FelTell/Keyboard-FT/Firmware/Roadmap.md

- Add bluetooth 
- Save connected devices in NVS
- Implement sleep
- Add LampArray operation to control LEDs from OS
