FelTell/Keyboard-FT/Hardware/Keyboard.kicad_pcb

## KiCad design Hardware/Keyboard.kicad_pcb (2024-02-05)

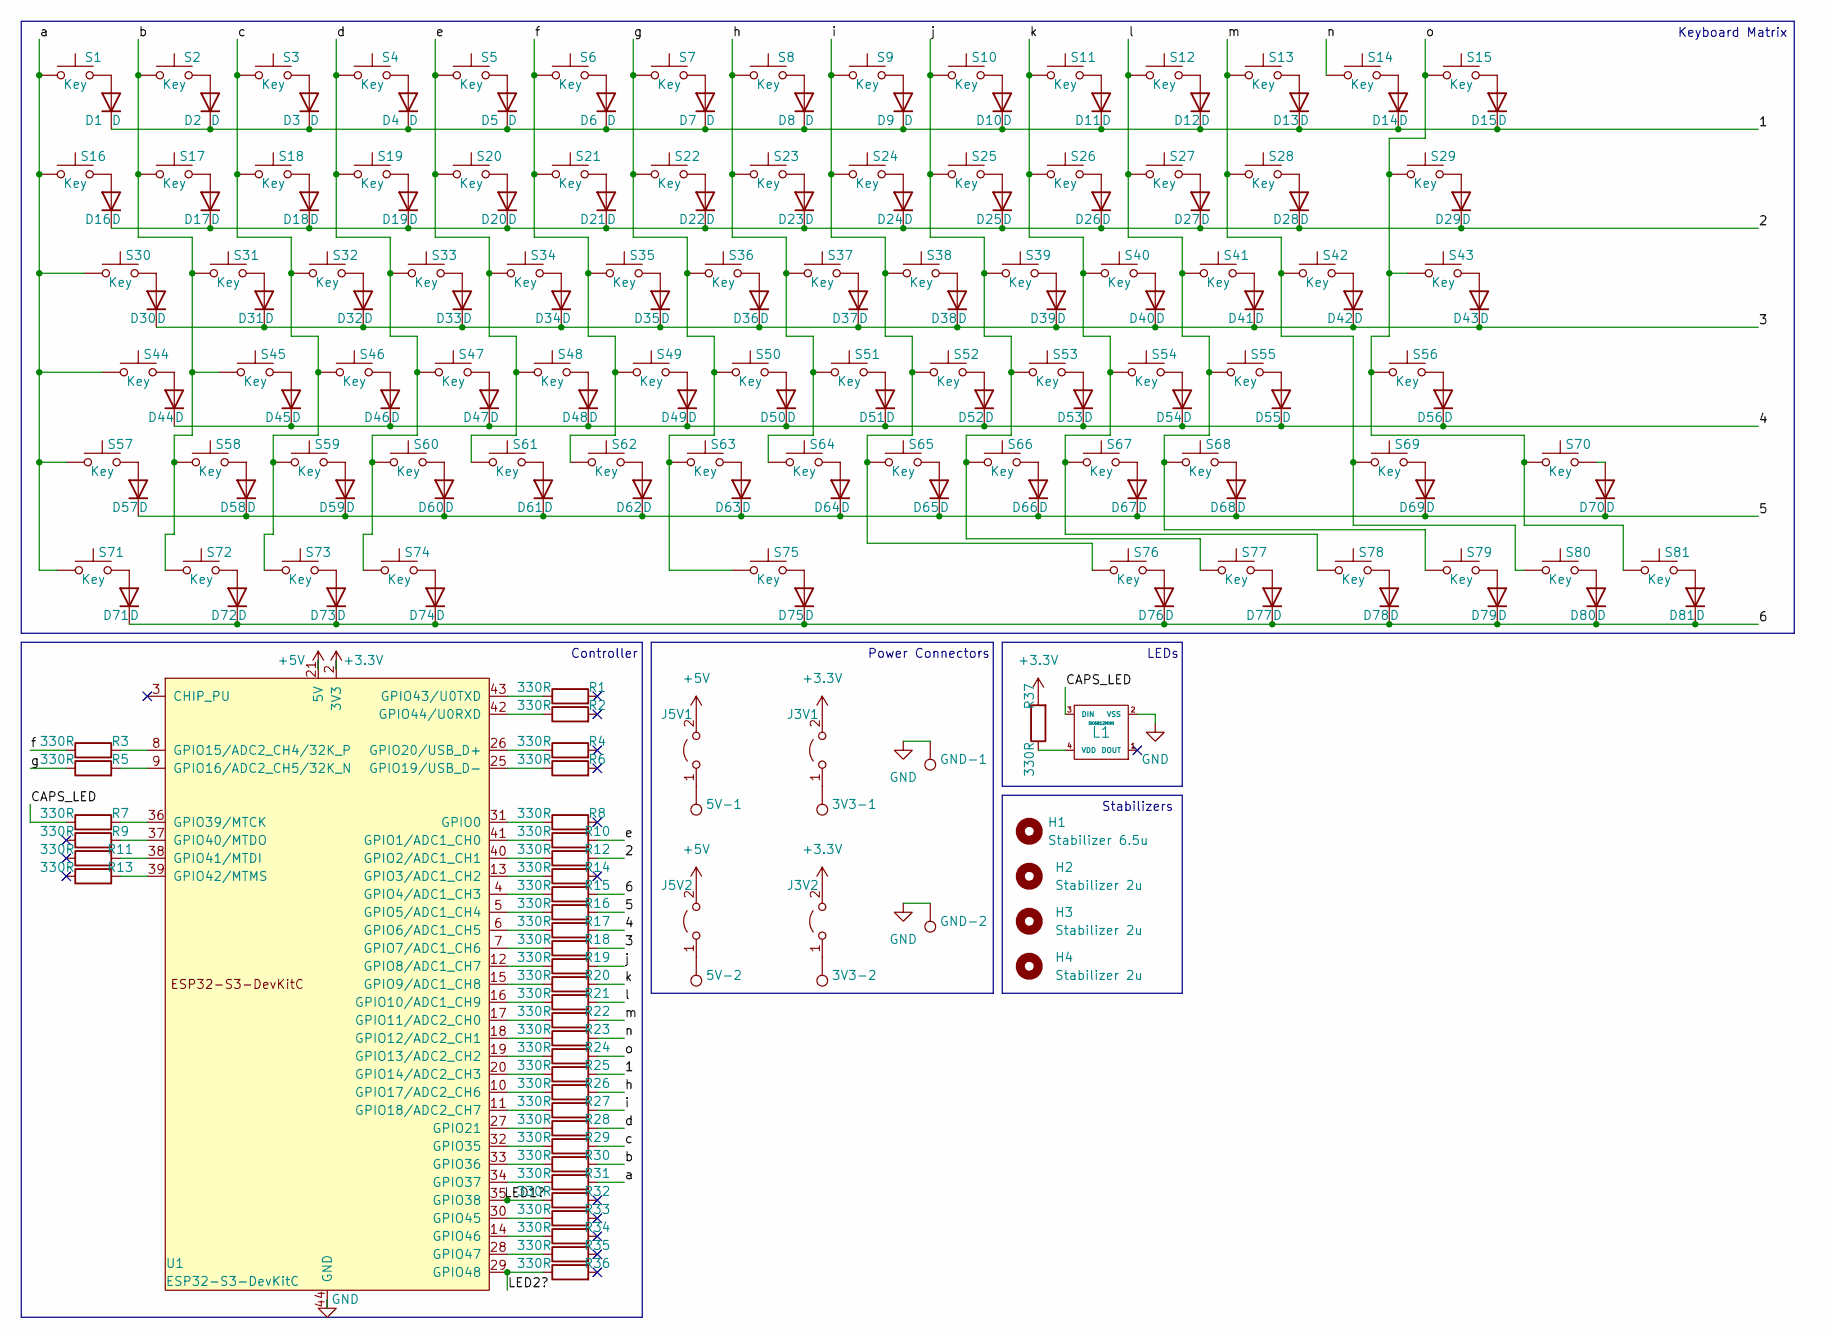
[picture p1: schematic PCB.kicad_sch, Keyboard-FT]

Parts:
3V3-1, 3V3-2, 5V-1, 5V-2: TestPoint; PinHeader_1x01_P1.00mm_Vertical
D1, D2, D3, D4, D5, D6, D7, D8, D9, D10, D11, D12, D13, D14, D15, D16, D17, D18, D19, D20, D21, D22, D23, D24, D25, D26, D27, D28, D29, D30, D31, D32, D33, D34, D35, D36, D37, D38, D39, D40, D41, D42, D43, D44, D45, D46, D47, D48, D49, D50, D51, D52, D53, D54, D55, D56, D57, D58, D59, D60, D61, D62, D63, D64, D65, D66, D67, D68, D69, D70, D71, D72, D73, D74, D75, D76, D77, D78, D79, D80, D81: D; D3_TH_SMD_v2
GND-1, GND-2: TestPoint; PinHeader_1x01_P1.00mm_Vertical
H1: Stabilizer 6.5u; Stabilizer_Cherry_MX_6.25u
H2, H3, H4: Stabilizer 2u; Stabilizer_Cherry_MX_2.00u
J3V1, J3V2, J5V1, J5V2: Jumper_2_Open; SolderJumper-2_P1.3mm_Open_TrianglePad1.0x1.5mm
L1: SK6812MINI; SK6812MINI_rev
R1, R2, R3, R4, R5, R6, R7, R8, R9, R10, R11, R12, R13, R14, R15, R16, R17, R18, R19, R20, R21, R22, R23, R24, R25, R26, R27, R28, R29, R30, R31, R32, R33, R34, R35, R36, R37: 330R; R_0603_1608Metric_Pad0.98x0.95mm_HandSolder
S1, S2, S3, S4, S5, S6, S7, S8, S9, S10, S11, S12, S13, S14, S15, S16, S17, S18, S19, S20, S21, S22, S23, S24, S25, S26, S27, S28, S31, S32, S33, S34, S35, S36, S37, S38, S39, S40, S41, S42, S45, S46, S47, S48, S49, S50, S51, S52, S53, S54, S55, S58, S59, S60, S61, S62, S63, S64, S65, S66, S67, S68, S70, S72, S73, S74, S77, S79, S80, S81: Key; SW_Cherry_MX_PCB_1.00u
S29: Key; SW_Cherry_MX_PCB_2.00u
S30, S43: Key; SW_Cherry_MX_PCB_1.50u
S44: Key; SW_Cherry_MX_PCB_1.75u
S56: Key; SW_Cherry_MX_PCB_2.25u
S57, S71, S76, S78: Key; SW_Cherry_MX_PCB_1.25u
S69: Key; SW_Cherry_MX_PCB_2.75u
S75: Key; SW_Cherry_MX_PCB_6.25u
U1: ESP32-S3-DevKitC

Connections:
+3.3V: J3V1.2 (B), J3V2.2 (B), R37.2, U1.1 (3V3), U1.2 (3V3)
+5V: J5V1.2 (B), J5V2.2 (B), U1.21 (5V)
/1: D1.1 (K), D2.1 (K), D3.1 (K), D4.1 (K), D5.1 (K), D6.1 (K), D7.1 (K), D8.1 (K), D9.1 (K), D10.1 (K), D11.1 (K), D12.1 (K), D13.1 (K), D14.1 (K), D15.1 (K), R25.2
/2: D16.1 (K), D17.1 (K), D18.1 (K), D19.1 (K), D20.1 (K), D21.1 (K), D22.1 (K), D23.1 (K), D24.1 (K), D25.1 (K), D26.1 (K), D27.1 (K), D28.1 (K), D29.1 (K), R12.2
/3: D30.1 (K), D31.1 (K), D32.1 (K), D33.1 (K), D34.1 (K), D35.1 (K), D36.1 (K), D37.1 (K), D38.1 (K), D39.1 (K), D40.1 (K), D41.1 (K), D42.1 (K), D43.1 (K), R18.2
/4: D44.1 (K), D45.1 (K), D46.1 (K), D47.1 (K), D48.1 (K), D49.1 (K), D50.1 (K), D51.1 (K), D52.1 (K), D53.1 (K), D54.1 (K), D55.1 (K), D56.1 (K), R17.2
/5: D57.1 (K), D58.1 (K), D59.1 (K), D60.1 (K), D61.1 (K), D62.1 (K), D63.1 (K), D64.1 (K), D65.1 (K), D66.1 (K), D67.1 (K), D68.1 (K), D69.1 (K), D70.1 (K), R16.2
/6: D71.1 (K), D72.1 (K), D73.1 (K), D74.1 (K), D75.1 (K), D76.1 (K), D77.1 (K), D78.1 (K), D79.1 (K), D80.1 (K), D81.1 (K), R15.2
/CAPS_LED: L1.3 (DIN), R7.1
/LED1?: R32.1, U1.35 (GPIO38)
/LED2?: R36.1, U1.29 (GPIO48)
/a: R31.2, S1.1, S16.1, S30.1, S44.1, S57.1, S71.1
/b: R30.2, S2.1, S17.1, S31.1, S45.1, S58.1, S72.1
/c: R29.2, S3.1, S18.1, S32.1, S46.1, S59.1, S73.1
/d: R28.2, S4.1, S19.1, S33.1, S47.1, S60.1, S74.1
/e: R10.2, S5.1, S20.1, S34.1, S48.1, S61.1
/f: R3.1, S6.1, S21.1, S35.1, S49.1, S62.1
/g: R5.1, S7.1, S22.1, S36.1, S50.1, S63.1, S75.1
/h: R26.2, S8.1, S23.1, S37.1, S51.1, S64.1
/i: R27.2, S9.1, S24.1, S38.1, S52.1, S65.1, S76.1
/j: R19.2, S10.1, S25.1, S39.1, S53.1, S66.1, S77.1
/k: R20.2, S11.1, S26.1, S40.1, S54.1, S67.1, S78.1
/l: R21.2, S12.1, S27.1, S41.1, S55.1, S68.1, S79.1
/m: R22.2, S13.1, S28.1, S42.1, S69.1, S80.1
/n: R23.2, S14.1
/o: R24.2, S15.1, S29.1, S43.1, S56.1, S70.1, S81.1
GND: GND-1.1, GND-2.1, L1.2 (VSS), U1.22 (GND), U1.23 (GND), U1.24 (GND), U1.44 (GND); also elsewhere on the board
unnamed: D1.2 (A), S1.2
unnamed: D2.2 (A), S2.2
unnamed: D3.2 (A), S3.2
unnamed: D4.2 (A), S4.2
unnamed: D5.2 (A), S5.2
unnamed: D6.2 (A), S6.2
unnamed: D7.2 (A), S7.2
unnamed: D8.2 (A), S8.2
unnamed: D9.2 (A), S9.2
unnamed: D10.2 (A), S10.2
unnamed: D11.2 (A), S11.2
unnamed: D12.2 (A), S12.2
unnamed: D13.2 (A), S13.2
unnamed: D14.2 (A), S14.2
unnamed: D15.2 (A), S15.2
unnamed: D16.2 (A), S16.2
unnamed: D17.2 (A), S17.2
unnamed: D18.2 (A), S18.2
unnamed: D19.2 (A), S19.2
unnamed: D20.2 (A), S20.2
unnamed: D21.2 (A), S21.2
unnamed: D22.2 (A), S22.2
unnamed: D23.2 (A), S23.2
unnamed: D24.2 (A), S24.2
unnamed: D25.2 (A), S25.2
unnamed: D26.2 (A), S26.2
unnamed: D27.2 (A), S27.2
unnamed: D28.2 (A), S28.2
unnamed: D29.2 (A), S29.2
unnamed: D30.2 (A), S30.2
unnamed: D31.2 (A), S31.2
unnamed: D32.2 (A), S32.2
unnamed: D33.2 (A), S33.2
unnamed: D34.2 (A), S34.2
unnamed: D35.2 (A), S35.2
unnamed: D36.2 (A), S36.2
unnamed: D37.2 (A), S37.2
unnamed: D38.2 (A), S38.2
unnamed: D39.2 (A), S39.2
unnamed: D40.2 (A), S40.2
unnamed: D41.2 (A), S41.2
unnamed: D42.2 (A), S42.2
unnamed: D43.2 (A), S43.2
unnamed: D44.2 (A), S44.2
unnamed: D45.2 (A), S45.2
unnamed: D46.2 (A), S46.2
unnamed: D47.2 (A), S47.2
unnamed: D48.2 (A), S48.2
unnamed: D49.2 (A), S49.2
unnamed: D50.2 (A), S50.2
unnamed: D51.2 (A), S51.2
unnamed: D52.2 (A), S52.2
unnamed: D53.2 (A), S53.2
unnamed: D54.2 (A), S54.2
unnamed: D55.2 (A), S55.2
unnamed: D56.2 (A), S56.2
unnamed: D57.2 (A), S57.2
unnamed: D58.2 (A), S58.2
unnamed: D59.2 (A), S59.2
unnamed: D60.2 (A), S60.2
unnamed: D61.2 (A), S61.2
unnamed: D62.2 (A), S62.2
unnamed: D63.2 (A), S63.2
unnamed: D64.2 (A), S64.2
unnamed: D65.2 (A), S65.2
unnamed: D66.2 (A), S66.2
unnamed: D67.2 (A), S67.2
unnamed: D68.2 (A), S68.2
unnamed: D69.2 (A), S69.2
unnamed: D70.2 (A), S70.2
unnamed: D71.2 (A), S71.2
unnamed: D72.2 (A), S72.2
unnamed: D73.2 (A), S73.2
unnamed: D74.2 (A), S74.2
unnamed: D75.2 (A), S75.2
unnamed: D76.2 (A), S76.2
unnamed: D77.2 (A), S77.2
unnamed: D78.2 (A), S78.2
unnamed: D79.2 (A), S79.2
unnamed: D80.2 (A), S80.2
unnamed: D81.2 (A), S81.2
unnamed 108: 3V3-1.1, J3V1.1 (A); also elsewhere on the board
unnamed: 3V3-2.1, J3V2.1 (A)
unnamed 110: 5V-1.1, J5V1.1 (A); also elsewhere on the board
unnamed: 5V-2.1, J5V2.1 (A)
unnamed: L1.4 (VDD), R37.1
unnamed: R8.1, U1.31 (GPIO0)
unnamed: R10.1, U1.41 (GPIO1/ADC1_CH0)
unnamed: R12.1, U1.40 (GPIO2/ADC1_CH1)
unnamed: R14.1, U1.13 (GPIO3/ADC1_CH2)
unnamed: R15.1, U1.4 (GPIO4/ADC1_CH3)
unnamed: R16.1, U1.5 (GPIO5/ADC1_CH4)
unnamed: R17.1, U1.6 (GPIO6/ADC1_CH5)
unnamed: R18.1, U1.7 (GPIO7/ADC1_CH6)
unnamed: R19.1, U1.12 (GPIO8/ADC1_CH7)
unnamed: R20.1, U1.15 (GPIO9/ADC1_CH8)
unnamed: R21.1, U1.16 (GPIO10/ADC1_CH9)
unnamed: R22.1, U1.17 (GPIO11/ADC2_CH0)
unnamed: R23.1, U1.18 (GPIO12/ADC2_CH1)
unnamed: R24.1, U1.19 (GPIO13/ADC2_CH2)
unnamed: R25.1, U1.20 (GPIO14/ADC2_CH3)
unnamed: R3.2, U1.8 (GPIO15/ADC2_CH4/32K_P)
unnamed: R5.2, U1.9 (GPIO16/ADC2_CH5/32K_N)
unnamed: R26.1, U1.10 (GPIO17/ADC2_CH6)
unnamed: R27.1, U1.11 (GPIO18/ADC2_CH7)
unnamed: R6.1, U1.25 (GPIO19/USB_D-)
unnamed: R4.1, U1.26 (GPIO20/USB_D+)
unnamed: R28.1, U1.27 (GPIO21)
unnamed: R29.1, U1.32 (GPIO35)
unnamed: R30.1, U1.33 (GPIO36)
unnamed: R31.1, U1.34 (GPIO37)
unnamed: R7.2, U1.36 (GPIO39/MTCK)
unnamed: R9.2, U1.37 (GPIO40/MTDO)
unnamed: R11.2, U1.38 (GPIO41/MTDI)
unnamed: R13.2, U1.39 (GPIO42/MTMS)
unnamed: R1.1, U1.43 (GPIO43/U0TXD)
unnamed: R2.1, U1.42 (GPIO44/U0RXD)
unnamed: R33.1, U1.30 (GPIO45)
unnamed: R34.1, U1.14 (GPIO46)
unnamed: R35.1, U1.28 (GPIO47)

Notes on the sheet:
Keyboard Matrix
Controller
Power Connectors
LEDs
Stabilizers

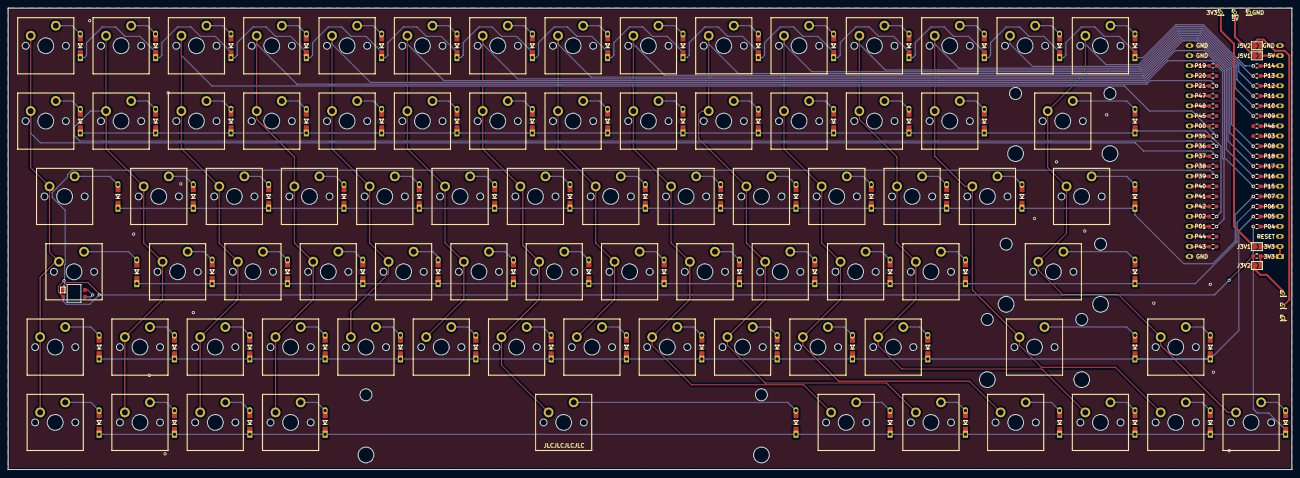
[picture p2: board Keyboard.kicad_pcb from above]

Board: 2 copper layers, 324.6 x 116.7 mm, 215 parts (1 on the bottom side), 147 nets.

Other parts of the board:
3V3, 5V: TestPoint; PinHeader_1x01_P1.00mm_Vertical
GND: TestPoint; PinHeader_1x01_P1.00mm_Vertical

Their connections:
GND: GND.1; also elsewhere on the board
unnamed 108: 3V3.1; also elsewhere on the board
unnamed 110: 5V.1; also elsewhere on the board
