FelTell/Keyboard-FT/Firmware/main/Src/UsbHid.cpp

#include "UsbHid.hpp"

#include <algorithm>
#include <cstdlib>

#include <class/hid/hid_device.h>
#include <esp_log.h>
#include <tinyusb.h>
#include <tinyusb_default_config.h>

#include "RtosUtils.hpp"

#include "Leds.hpp"

namespace usb_hid {

static constexpr uint8_t REPORT_MAX_KEYS = 6;
static constexpr uint8_t REPORT_SIZE     = 2 + REPORT_MAX_KEYS;

static bool Init();
static void Handler();

static void PollConnection();
static void PrintReport(std::array<uint8_t, REPORT_SIZE>& report);

static rtos::Task task("UsbHidTask", 4096, 23, Init, Handler, 0);
static rtos::Timer pollConnectionTimer("PollConnectionTimer",
                                       100,
                                       true,
                                       PollConnection);
static rtos::Queue<KbHidReport> kbReportsQueue(10);
// TODO (Felipe): This should be a semaphore
static rtos::Event hidReady;

static bool isReady;

// TinyUSB descriptors

static constexpr uint8_t KEYBOARD_REPORT_ID = 1;
static constexpr uint8_t CONSUMER_REPORT_ID = 3;

static constexpr uint32_t TUSB_DESC_TOTAL_LEN =
    TUD_CONFIG_DESC_LEN + CFG_TUD_HID * TUD_HID_DESC_LEN;

static const uint8_t reportDescriptor[] = {
    TUD_HID_REPORT_DESC_KEYBOARD(HID_REPORT_ID(KEYBOARD_REPORT_ID)),
    TUD_HID_REPORT_DESC_CONSUMER(HID_REPORT_ID(CONSUMER_REPORT_ID))};

static const char* stringDescriptor[5] = {
    (char[]){0x09, 0x04}, // 0: is supported language is English (0x0409)
    "FelTell",            // 1: Manufacturer
    "Keyboard-FT",        // 2: Product
    "0000001",            // 3: Serial,
    "Keyboard-FT V1.0",   // 4: HID
};

static const uint8_t configurationDescriptor[] = {
    TUD_CONFIG_DESCRIPTOR(1,
                          1,
                          0,
                          TUSB_DESC_TOTAL_LEN,
                          TUSB_DESC_CONFIG_ATT_REMOTE_WAKEUP,
                          100),

    TUD_HID_DESCRIPTOR(0, 4, false, sizeof(reportDescriptor), 0x81, 16, 10),
};

bool SendReport(KbHidReport kbHidReport) {
    return kbReportsQueue.Send(kbHidReport);
}

static bool Init() {
    tinyusb_config_t tinyUsbConfig             = TINYUSB_DEFAULT_CONFIG();
    tinyUsbConfig.task.priority                = 24;
    tinyUsbConfig.task.xCoreID                 = 0;
    tinyUsbConfig.descriptor.device            = NULL;
    tinyUsbConfig.descriptor.full_speed_config = configurationDescriptor;
    tinyUsbConfig.descriptor.string            = stringDescriptor;
    tinyUsbConfig.descriptor.string_count =
        sizeof(stringDescriptor) / sizeof(stringDescriptor[0]);

    ESP_ERROR_CHECK(tinyusb_driver_install(&tinyUsbConfig));

    pollConnectionTimer.Start();

    return true;
}

static void Handler() {
    static uint16_t lastConsumerCode;
    static std::array<uint8_t, REPORT_SIZE> keyCodes = {};

    hidReady.Wait(1);
    KbHidReport report;
    kbReportsQueue.Wait(report);

    if (lastConsumerCode != report.consumerCode) {
        lastConsumerCode = report.consumerCode;
        tud_hid_report(CONSUMER_REPORT_ID, &lastConsumerCode, 2);
        ESP_LOGI("ConsumerReport: ", "%d", report.consumerCode);
        return;
    }

    keyCodes[0] = report.modifiers;
    memcpy(&keyCodes[2], report.keys.data(), REPORT_MAX_KEYS);

    hidReady.Clear(1);
    tud_hid_report(KEYBOARD_REPORT_ID, keyCodes.data(), REPORT_SIZE);

    PrintReport(keyCodes);

    leds::ResetTimeout();
}

static void PollConnection() {
    const bool tinyUsbReady = tud_ready();
    if (isReady != tinyUsbReady) {
        isReady = tinyUsbReady;
        if (!isReady) {
            isReady = false;
            leds::SendCommand(leds::Commands::NotConnected);
        } else if (leds::GetMode() == leds::Commands::NotConnected) {
            leds::SendCommand(leds::Commands::Usb);
        }
    }
}

static void PrintReport(std::array<uint8_t, REPORT_SIZE>& report) {
    uint16_t textIndex         = 0;
    std::array<char, 100> text = {""};

    for (uint16_t i = 0; i < REPORT_SIZE; ++i) {
        textIndex += snprintf(&text[textIndex],
                              sizeof(text) - textIndex,
                              "%d ",
                              report[i]);
    }
    ESP_LOGI("Report: ", "%s", text.data());
}

bool SetupTask() {
    if (hidReady.Setup() == false) {
        return false;
    }
    hidReady.Set(1);
    if (!kbReportsQueue.Setup()) {
        return false;
    }
    if (!task.Setup()) {
        return false;
    }
    return true;
}

} // namespace usb_hid

// TinyUSB HID callbacks

extern "C" const uint8_t* tud_hid_descriptor_report_cb(
    [[maybe_unused]] uint8_t instance) {
    return usb_hid::reportDescriptor;
}

extern "C" uint16_t tud_hid_get_report_cb(
    [[maybe_unused]] uint8_t instance,
    [[maybe_unused]] uint8_t id,
    [[maybe_unused]] hid_report_type_t type,
    [[maybe_unused]] uint8_t* buf,
    [[maybe_unused]] uint16_t realen) {
    return 0;
}

extern "C" void tud_hid_set_report_cb([[maybe_unused]] uint8_t instance,
                                      uint8_t id,
                                      hid_report_type_t type,
                                      const uint8_t* buf,
                                      uint16_t size) {
    if (id != 1 && type != HID_REPORT_TYPE_OUTPUT && size != 1) {
        // Unknown message, log and ignore it
        uint16_t index = 0;
        std::array<char, 100> text;
        for (uint16_t i = 0; i < size; ++i) {
            index +=
                snprintf(&text[index], sizeof(text) - index, "%x ,", buf[i]);
        }
        ESP_LOGI("set report cb",
                 "id: %d, type: %d, size: %d, buf: %s",
                 id,
                 type,
                 size,
                 buf);
        return;
    }
    bool capsState = buf[0] & KEYBOARD_LED_CAPSLOCK;
    leds::SendCommand(capsState ? leds::Commands::CapsOnUsb
                                : leds::Commands::Usb);
}

extern "C" void tud_hid_report_complete_cb(
    [[maybe_unused]] uint8_t instance,
    [[maybe_unused]] const uint8_t* report,
    [[maybe_unused]] uint16_t len) {
    usb_hid::hidReady.Set(1);
}
