FelTell/Keyboard-FT/Firmware/main/Src/Matrix.cpp

#include "Matrix.hpp"

#include <array>

#include <class/hid/hid_device.h>
#include <driver/gpio.h>
#include <esp_bit_defs.h>

#include <esp_log.h>

#include "RtosUtils.hpp"

#include "Layout.hpp"
#include "UsbHid.hpp"

namespace matrix {

static bool Init();
static void Handler();
static bool PollChanges();
static usb_hid::KbHidReport GenerateReport();
static bool IsFnPressed();

static rtos::Task task("MatrixTask", 4096, 24, Init, Handler, 1);

static const std::array<gpio_num_t, layout::ROWS_NUM> rows = {
    GPIO_NUM_14,
    GPIO_NUM_2,
    GPIO_NUM_7,
    GPIO_NUM_6,
    GPIO_NUM_5,
    GPIO_NUM_4,
};
static const std::array<gpio_num_t, layout::COLUMNS_NUM> columns = {
    GPIO_NUM_37,
    GPIO_NUM_36,
    GPIO_NUM_35,
    GPIO_NUM_21,
    GPIO_NUM_1,
    GPIO_NUM_15,
    GPIO_NUM_16,
    GPIO_NUM_17,
    GPIO_NUM_18,
    GPIO_NUM_8,
    GPIO_NUM_9,
    GPIO_NUM_10,
    GPIO_NUM_11,
    GPIO_NUM_12,
    GPIO_NUM_13,
};

static bool Init() {
    gpio_config_t config;
    config.pull_up_en = GPIO_PULLUP_DISABLE;
    config.intr_type  = GPIO_INTR_DISABLE;

    config.pull_down_en = GPIO_PULLDOWN_ENABLE;
    config.mode         = GPIO_MODE_INPUT;
    for (gpio_num_t gpioNum : rows) {
        config.pin_bit_mask = BIT64(gpioNum);
        gpio_config(&config);
    }

    config.pull_down_en = GPIO_PULLDOWN_DISABLE;
    config.mode         = GPIO_MODE_OUTPUT;
    for (gpio_num_t gpioNum : columns) {
        config.pin_bit_mask = BIT64(gpioNum);
        gpio_config(&config);
    }
    return true;
}

static void Handler() {
    if (PollChanges()) {
        usb_hid::SendReport(GenerateReport());
    }
}

static bool PollChanges() {
    bool changePresent = false;

    for (uint8_t column = 0; column < layout::COLUMNS_NUM; ++column) {
        gpio_set_level(columns[column], true);
        // Quick blocking delay to make sure gpio is in the correct level
        volatile uint32_t i = 5;
        while (i) {
            i = i - 1;
        }
        for (uint8_t row = 0; row < layout::ROWS_NUM; ++row) {
            Key& key   = layout::keys[column][row];
            bool state = gpio_get_level(rows[row]);
            if (key.HandleStateChange(state)) {
                changePresent = true;
                ESP_LOGI(key.GetText(),
                         "has been %s. ID = %d. Row = %d, Column = %d. GPIO = "
                         "%d and %d.",
                         key.GetState() ? "pressed" : "released",
                         key.GetCode(),
                         row,
                         column,
                         rows[row],
                         columns[column]);
            }
        }
        gpio_set_level(columns[column], false);
    }

    return changePresent;
}

static usb_hid::KbHidReport GenerateReport() {
    usb_hid::KbHidReport report = {};

    const bool isFnPressed = IsFnPressed();

    for (uint16_t i = 0; i < layout::COLUMNS_NUM * layout::ROWS_NUM; ++i) {
        const auto key = layout::keys[0][i];

        if (!key.GetState()) {
            key.DoFnFunction(false);
            continue;
        }

        if (!key.GetCode()) {
            report.modifiers = report.modifiers | key.GetModifier();
            continue;
        }

        if (!isFnPressed) {
            report.keys[report.size++] = key.GetCode();
            continue;
        }

        report.keys[report.size++] = key.GetFnKeyCode();
        report.consumerCode        = key.GetFnConsumerCode();
        key.DoFnFunction(true);
    }

    return report;
}

static bool IsFnPressed() {
    return layout::keys[1][5].GetState();
}

bool SetupTask() {
    if (!task.Setup()) {
        return false;
    }
    return true;
}

} // namespace matrix
