FelTell/Keyboard-FT/Firmware/main/Inc/Leds.hpp

#pragma once

#include <cstdint>

namespace leds {

enum class Commands : uint8_t {
    CapsOnUsb = 0,
    CapsOnBle,
    Usb,
    BluetoothSearching,
    BluetoothConnected,
    NotConnected,
    Error,

    DecreaseBrightness = 20,
    IncreaseBrightness,
    Disable,
};

bool SendCommand(Commands);
Commands GetMode();

bool SetupTask();

void DecreaseBrightness(bool);
void IncreaseBrightness(bool);

void ResetTimeout();

} // namespace leds
