FelTell/Keyboard-FT/(commit log)

2023-07-16 added some configuration files
    [BluepillTest.cfg]
2024-01-10 hardware init
    [PCB.kicad_pcb, PCB.kicad_sch]
2024-01-10 finished tracing
    [PCB.kicad_pcb]
2024-01-21 sch changes
    [PCB-B_Cu.gbr, PCB-B_Mask.gbr, PCB-B_Paste.gbr, PCB-B_Silkscreen.gbr, PCB-Edge_Cuts.gbr, PCB-F_Cu.gbr, PCB-F_Mask.gbr, PCB-F_Paste.gbr]
2024-01-21 added tracks
    [PCB.kicad_pcb, PCB.kicad_sch]
2024-01-23 final hardware
    [PCB-B_Cu.gbr, PCB-B_Mask.gbr, PCB-B_Paste.gbr, PCB-B_Silkscreen.gbr, PCB-Edge_Cuts.gbr, PCB-F_Cu.gbr, PCB-F_Mask.gbr, PCB-F_Paste.gbr]
2024-01-23 fixed name
    [PCB.kicad_pcb]
2024-01-23 added gebers
    [PCB-B_Cu.gbr, PCB-B_Mask.gbr, PCB-B_Paste.gbr, PCB-B_Silkscreen.gbr, PCB-Edge_Cuts.gbr, PCB-F_Cu.gbr, PCB-F_Mask.gbr, PCB-F_Paste.gbr]
2024-01-24 fixed output files
    [PCB-B_Cu.gbl, PCB-B_Mask.gbs, PCB-B_Paste.gbp, PCB-B_Paste.gbr, PCB-B_Silkscreen.gbo, PCB-Edge_Cuts.gm1, PCB-F_Cu.gtl, PCB-F_Mask.gts]
2024-02-05 removed old fw
    [BluepillTest.cfg]
2024-02-05 uodated git ignore
    [PCB-B_Cu.gbl, PCB-B_Mask.gbs, PCB-B_Paste.gbp, PCB-B_Silkscreen.gbo, PCB-Edge_Cuts.gm1, PCB-F_Cu.gtl, PCB-F_Mask.gts, PCB-F_Paste.gtp]
2024-02-05 project renaming
    [Keyboard.kicad_pcb, Keyboard.kicad_sch]
2024-02-05 fixed minor disalignment
    [Keyboard.kicad_pcb]
2024-02-06 working led
2024-02-06 added status led task
2024-02-06 git cache reset
    [Keyboard.kicad_pcb, Keyboard.kicad_sch]
2024-02-10 improved status led
2024-02-22 showing caps led
2024-02-27 added matrix delay to ensure proper gpio timing fixed not sending modifiers and keys
    [Matrix.cpp]
2024-02-28 added caps leds renamed namespace to just led
2024-03-02 fixed wrong caps led when connecting
    [StatusLed.cpp, UsbHid.cpp]
2024-03-02 added timer class
2024-03-16 added led brightness adjust
2024-03-16 renamed statusled file to leds
2024-03-16 sending report every 100 ms to prevent stuck keys when a device has been woken up by the keyboard
    [UsbHid.cpp]
2024-03-16 fixed some fn commands not working
    [Matrix.cpp]
2025-03-12 implemented LED timeout
2026-05-03 fixed wrong led command when multiple command are sent.
    [Leds.cpp]
2026-07-29 fixed sdkconfig and usb task setup
    [UsbHid.cpp]
2026-08-12 added tud_hid_report_complete_cb to fix missing reports
    [Key.hpp, Matrix.cpp, UsbHid.cpp]
